lileetung/SparrowFlight/docs/videos/README.md

# Videos

A test flight of Sparrow, flown from an iPhone with the SparrowFlight app.

https://github.com/user-attachments/assets/7a1055ea-dd3d-42d8-9035-7807f2834d85
