lileetung/SparrowFlight/docs/photos/README.md

# Photos

Photos of the built Sparrow. The READMEs show 3D renders instead; these show the real parts.

<p align="center">
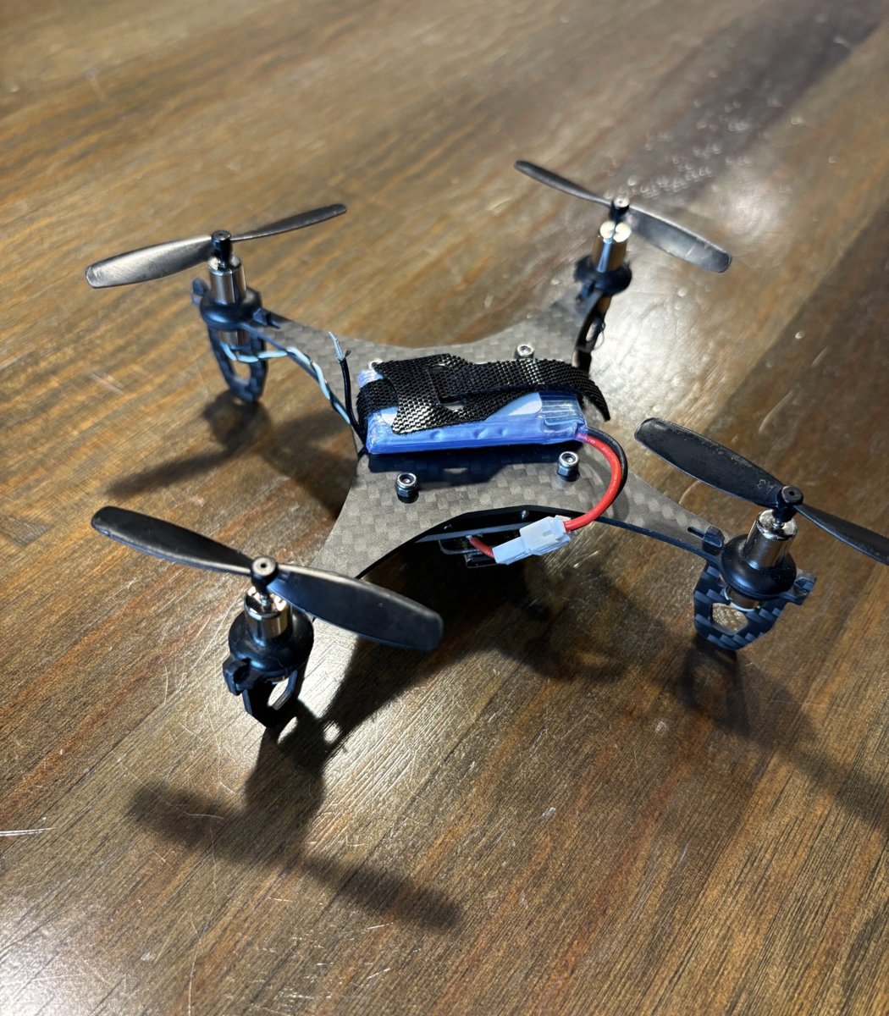
[picture p12: docs/photos/sparrow-front.jpg]
Sparrow from the front: carbon-fibre frame, four coreless motors with 55 mm propellers, and a 1S battery strapped on top
  
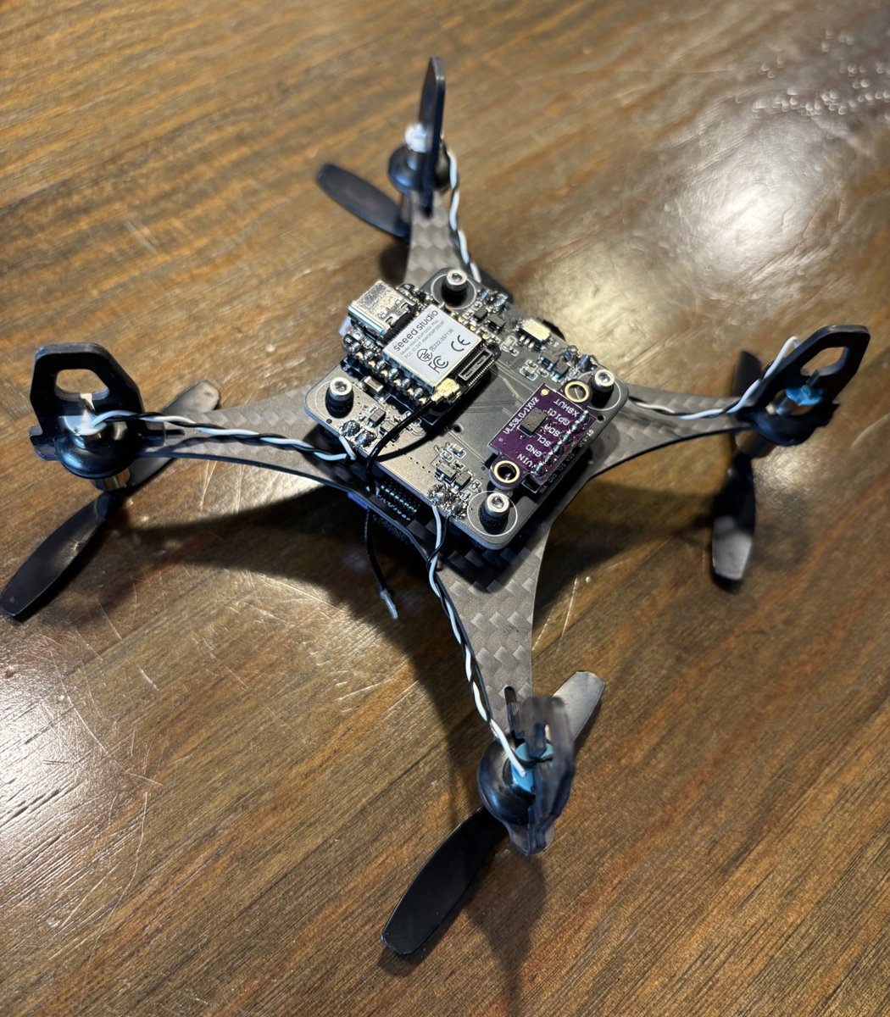
[picture p13: docs/photos/sparrow-back.jpg]
Sparrow from below: the flight controller with the XIAO ESP32-S3 and the downward ToF sensor
  
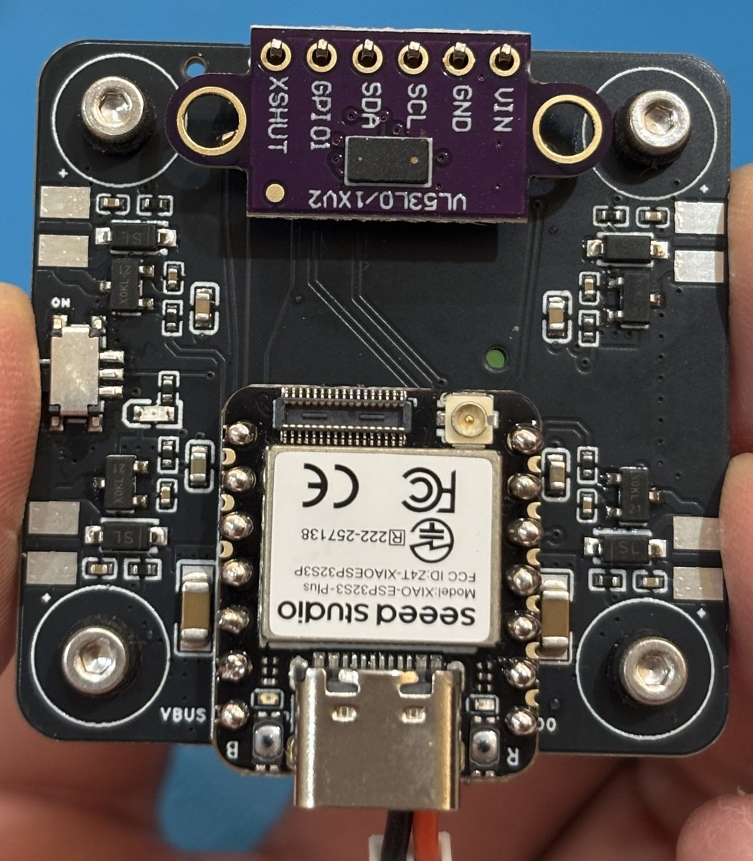
[picture p14: docs/photos/flight-controller-top.jpg]
The 40 x 40 mm flight controller: the GY-530 ToF module, the XIAO ESP32-S3 and the four grommet holes
  
</p>

From left to right:

1. Sparrow from the front, with the 1S battery strapped on top.
2. Sparrow from below, with the XIAO ESP32-S3 and the GY-530 ToF sensor on the flight controller.
3. The flight controller with the XIAO ESP32-S3 Plus and the GY-530.
