lileetung/SparrowFlight/SUPPORT.md

# Support

## Help with the app

[software/README.md](software/README.md) covers connecting, the check after connecting, the flight modes, the controls, the camera, the parameters and the flight logs.

## Help with building

[hardware/](hardware/README.md) covers ordering and assembling the frame and the flight controller. [firmware/](firmware/README.md) covers building and flashing the firmware, the console commands, the parameters and the calibration.

## Reporting a problem

Open an issue at <https://github.com/lileetung/SparrowFlight/issues>, or email <leetung0718@gmail.com> if you have no GitHub account. It helps to include:

- the app version (Settings > About) and the firmware version (shown at the top of the screen once connected)
- what you did, what you expected and what happened
- the flight log of that connection, if there is one: in the Files app under On My iPhone > SparrowFlight > logs, the `.csv` and `.events.txt` files with that date and time

## Privacy

The app collects no personal data. See the [privacy policy](software/PRIVACY.md).
