lileetung/SparrowFlight/hardware/flight-controller/sparrow-fc-v1.0-bom.csv

Comment | Designator | Footprint | LCSC Part # | Manufacturer Part
10uF | C1,C2 | C0805 | C15850 | CL21A106KAYNNNE
100nF | C3,C8,C17,C18,C19,C20,C27,C28,C29,C30 | C0402 | C1525 | CL05B104KO5NNNC
22uF | C4,C5,C6 | C0805 | C45783 | CL21A226MAQNNNE
100uF | C7,C9 | C1206 | C15008 | CL31A107MQHNNNE
10uF | C21,C22,C23,C24 | C0603 | C19702 | CL10A106KP8NNNC
KT-0603R | D2 | LED-SMD_L1.6-W0.8-R-RD | C2286 | KT-0603R
B5819W SL | D3,D4,D5,D6 | SOD-123_L2.7-W1.6-LS3.7-RD-1 | C8598 | B5819W SL
B5819WS | D7 | SOD-323_L1.8-W1.3-LS2.5-RD | C64886 | B5819WS
1.5uH | L1 | IND-SMD_L4.0-W4.0 | C340376 | YNR4020-1R5N
AO3400A | Q2,Q3,Q4,Q5 | SOT-23-3_L2.9-W1.3-P1.90-LS2.4-BR | C20917 | AO3400A
CSD13202Q2 | Q6 | SON-8_L2.0-W2.0_CSD17313Q2T | C187839 | CSD13202Q2
10kΩ | R2,R22,R24,R25 | R0402 | C25744 | 0402WGF1002TCE
1MΩ | R3 | R0402 | C26083 | 0402WGF1004TCE
120kΩ | R4 | R0603 | C25808 | 0603WAF1203T5E
100kΩ | R5,R6 | R0402 | C25741 | 0402WGF1003TCE
1kΩ | R8,R23 | R0402 | C11702 | 0402WGF1001TCE
220Ω | R18,R19,R20,R21 | R0402 | C25091 | 0402WGF2200TCE
SS-205-AGS7P-150 | SW1 | SW-SMD_SS-205-AGS7P-150 | C42377849 | SS-205-AGS7P-150
TPS63020DSJR | U1 | VSON-14_L4.0-W3.0-P0.50-BL-EP_TI_DSJ | C15483 | TPS63020DSJR
