lileetung/SparrowFlight/hardware/frame/sparrow-frame-v1.0.dxf

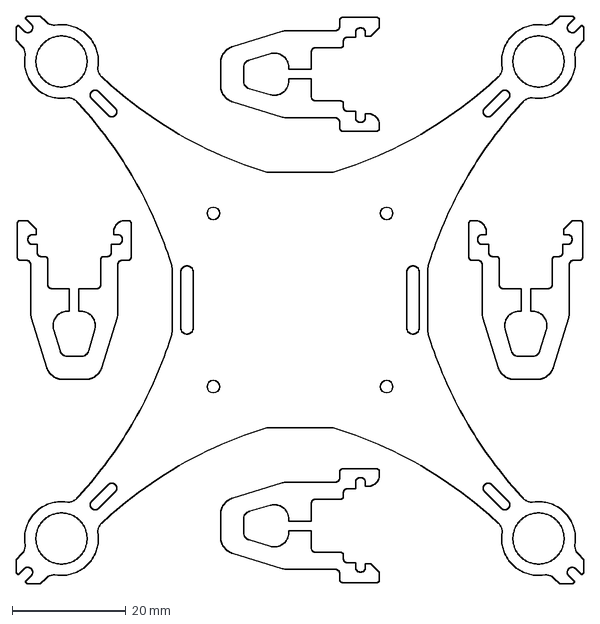
[picture p15: CAD file, 2026-11-04]
hardware/frame/sparrow-frame-v1.0.dxf
100.0 x 100.0 mm
