lileetung/SparrowFlight/(commit log)

2026-11-02 Lead the READMEs with building Sparrow from parts that are easy to get
    The point of the project is a small quadcopter anyone can build from
    off-the-shelf modules and common hobby parts, so the opening says that,
    and the frame, flight controller and firmware come before the app.
2026-11-02 Add a Parts section to the READMEs
    Lists the modules and hobby parts Sparrow is built from, with what each
    one does, and links the XIAO ESP32-S3, MPU-6050 and VL53L0X to their
    makers' pages. The full bill of materials comes with the hardware.
2026-11-02 Write hardware versions without a v, like the firmware and the app
    Versions in text are plain numbers: the frame and the flight controller
    1.0, the firmware and the app 1.0.0. The v stays in tag and file names.
2026-11-04 Update the docs for app 1.0.1
    - App guide: the wait for the drone's address and the new link messages
    in app 1.0.1.
    - READMEs: no English markers after links in the Chinese README, four
    highlights, and the motor collars named as sold.
    - Licence note: no sentence on the iOS app.
2026-11-04 Publish firmware 1.0.0, frame 1.0 and flight controller 1.0
    - firmware/: flight firmware for the XIAO ESP32-S3 Plus, built with
    PlatformIO, under GPL-3.0-or-later.
    - hardware/frame/: the carbon-fibre frame DXF, its drawing and a 3D
    render, under CC BY-NC-SA 4.0, adapted from LiteWing by Circuit Digest.
    - hardware/flight-controller/: the EasyEDA Pro project, schematic PDF,
    Gerber, BOM and pick-and-place files, layout image and 3D renders,
    under CERN-OHL-S-2.0.
    - READMEs: specifications and parts with shops, build steps and 3D
    renders; photos of the built drone in docs/photos.
    - LICENSE.md, CHANGELOG.md, CONTRIBUTING.md and the bug report form
    cover the firmware and the hardware.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
    [sparrow-fc-v1.0-bom.csv, sparrow-frame-v1.0.dxf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]
2026-11-04 Embed the test flight video so it plays on phones
    GitHub does not play an mp4 from the repository file view, so the
    README link led to a page with only View raw, and on phones the clip
    could not be watched. The clip now plays inline from a GitHub upload.
    Trim the clip from 36 s to 30 s by cutting the wait while the phone
    joins the drone's WiFi, and drop the copy in docs/videos.
2026-11-04 Add an exploded view and correct the mounting stack
    The frame README now opens its assembly steps with a numbered
    exploded view of the whole drone.
    The text and the renders had the flight controller mount upside
    down. Each M2 screw goes up from under the board, through the
    grommet, washer and frame, and the nylon lock nut sits on top of the
    frame. Step 3 now says so, and the two README renders are drawn again
    from the same model with the nuts on top, the screw heads under the
    board and the double-flanged motor collars.
    The battery is held by a nylon cable tie, not a strap: it goes down
    one slot, across between the frame and the GY-521, and up the other.
    Step 4, the slot row and both parts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
